friarbayliff/BBCLab/EAGLE/MSSRP-Sensor/BOM/MSSRP-Temperature_System_beta_lite_2layer.brd

## EAGLE design EAGLE/MSSRP-Sensor/BOM/MSSRP-Temperature_System_beta_lite_2layer.brd (2014-07-03)

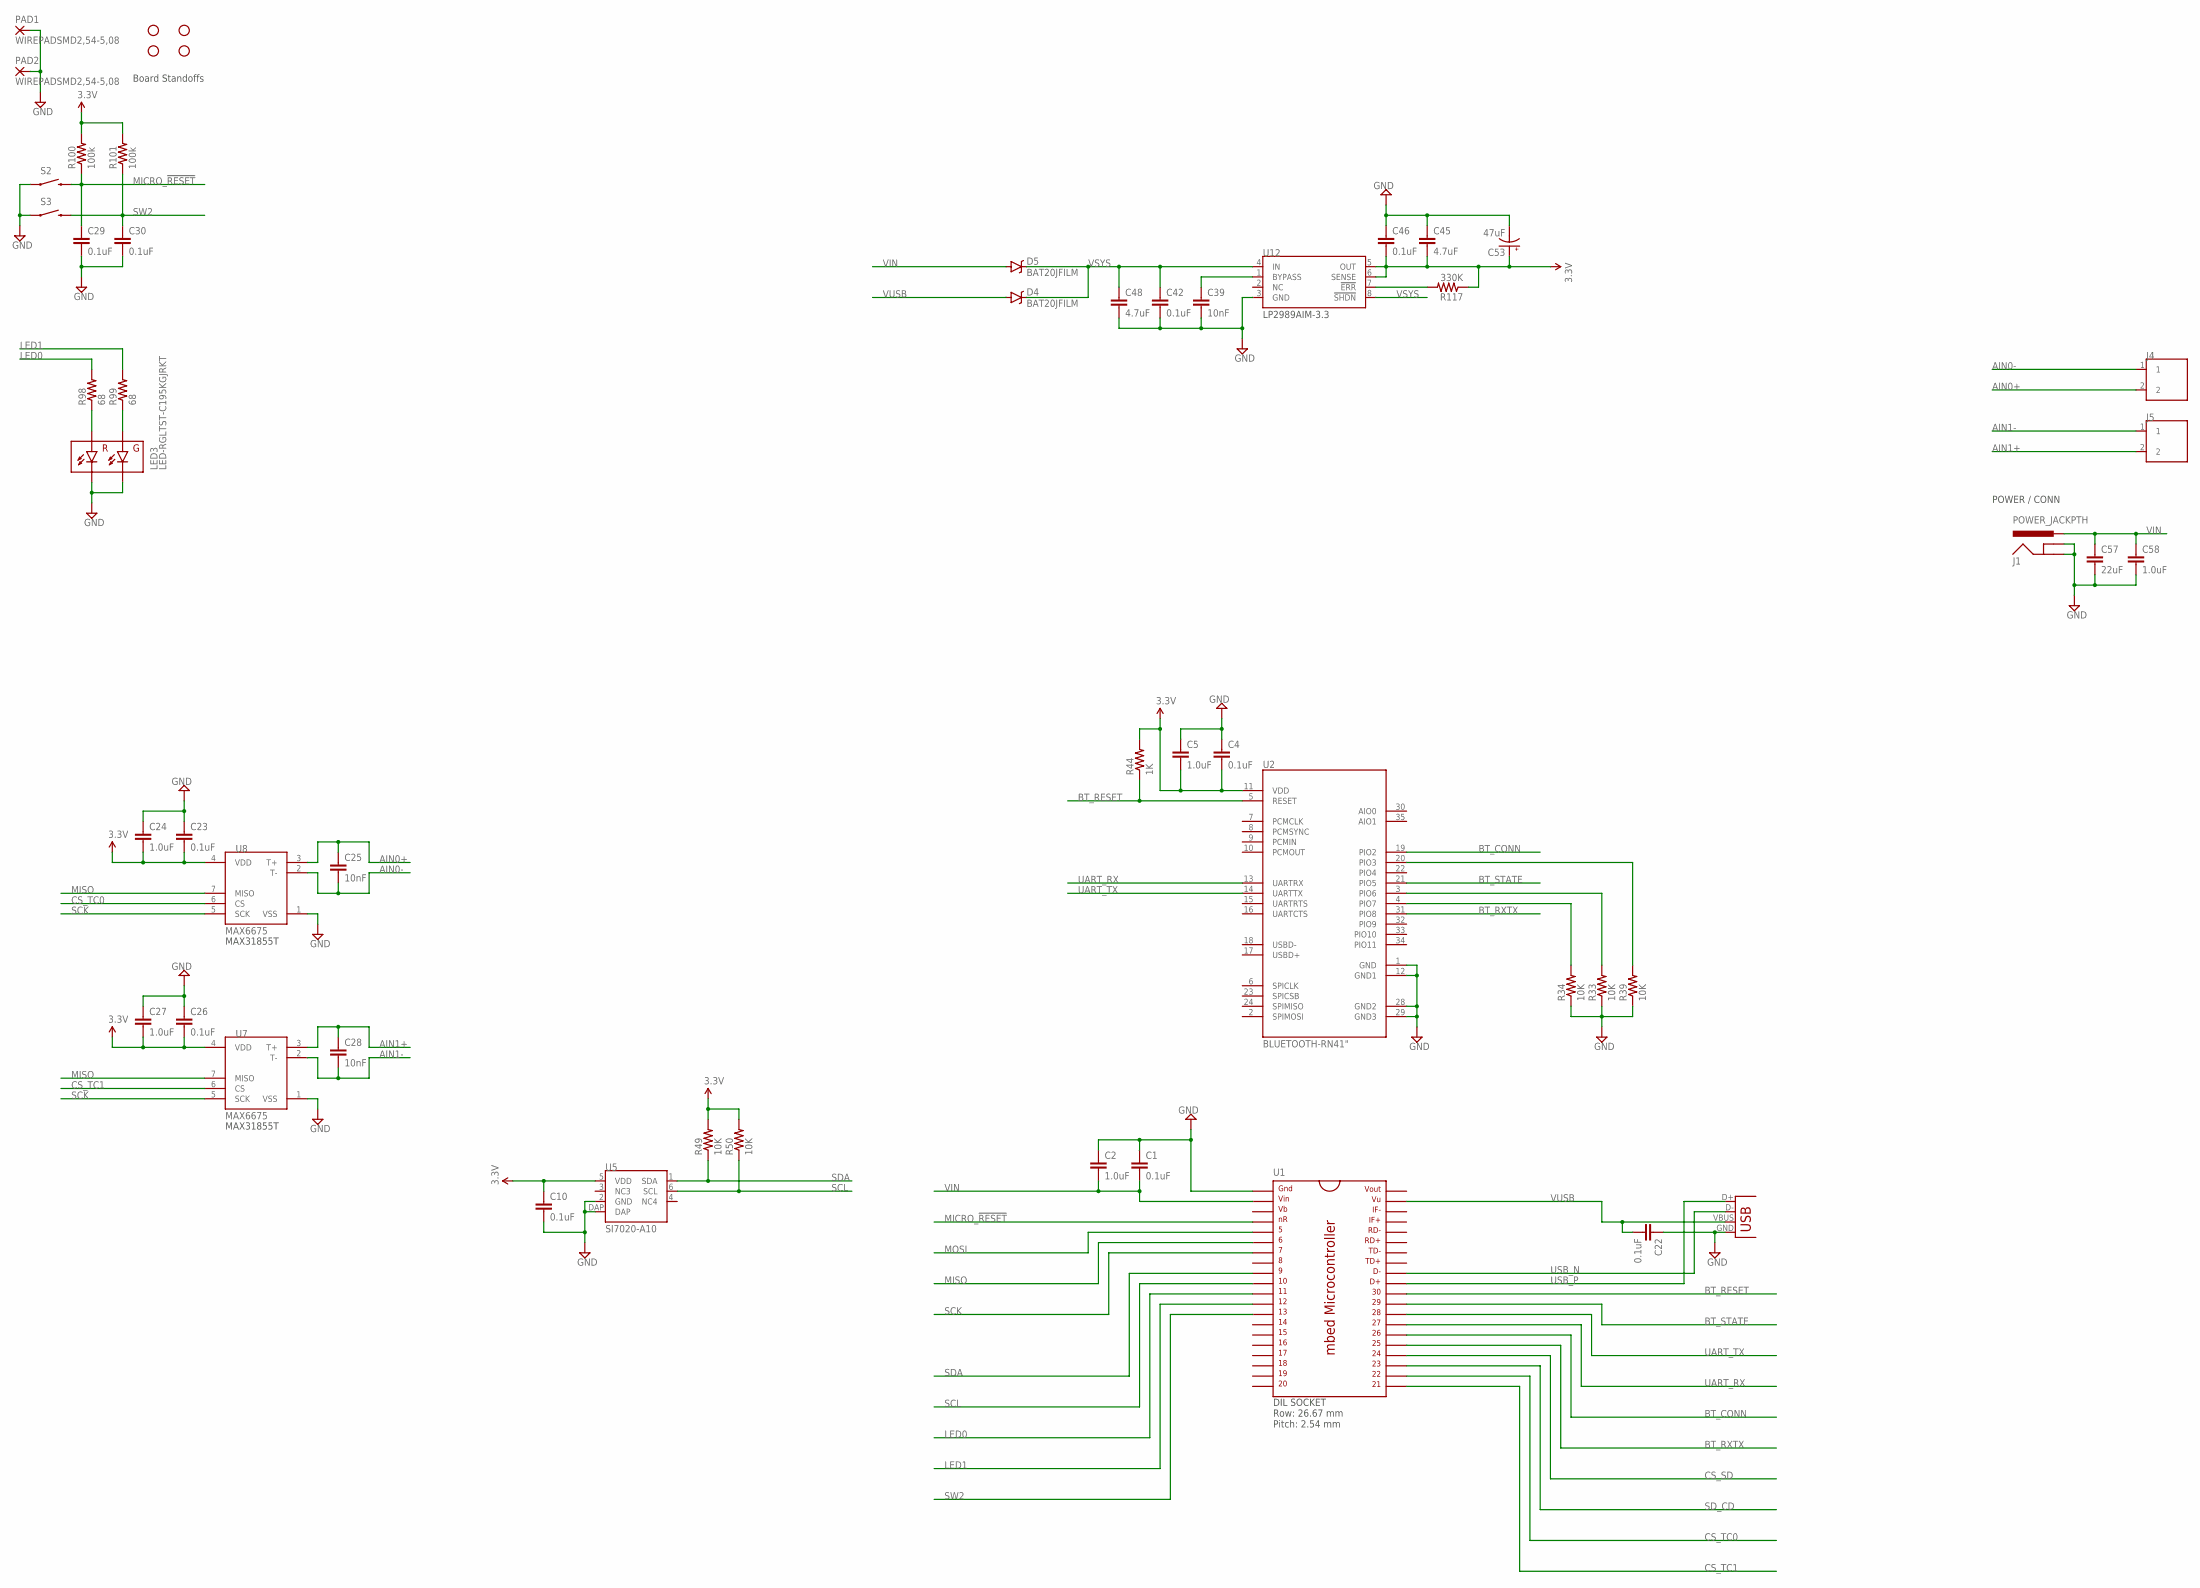
[picture p1: schematic MSSRP-Temperature_System_beta_lite_2layer.sch]

Parts:
C1, C4, C10, C22, C23, C26, C29, C30, C42, C46: 0.1uF; 0603-CAP
C2, C5, C24, C27, C58: 1.0uF; 0603-CAP
C25, C28, C39: 10nF; 0603-CAP
C45, C48: 4.7uF; 0603-CAP
C53: 47uF; EIA3528
C57: 22uF; 1210
D4, D5: BAT20JFILM; SOD-323
J1: POWER_JACKPTH; POWER_JACK_PTH
J4, J5: TE-2-TERMBLOCK
JP1: USB-A-SMD; USB-A-S-NOSILK-FEMALE
LED3: LED-RGLTST-C195KGJRKT; LTST-C195KGJRKT
PAD1, PAD2: WIREPADSMD2,54-5,08; SMD2,54-5,08
R33, R34, R39, R49, R50: 10K; 0603-RES
R44: 1K; 0603-RES
R98, R99: 68; 0603-RES
R100, R101: 100k; 0603-RES
R117: 330K; 0603-RES
S2, S3: SWITCH-MOMENTARY-2-SMD-1101NE; TACTILE-SWITCH-1101NE
STANDOFF1, STANDOFF2, STANDOFF3, STANDOFF4: STAND-OFF
U1: MBED; DIL40_0.9
U2: BLUETOOTH-RN41"; RN41
U5: SI7020-A10; DFN6
U7, U8: MAX6675; SO08-MAX6675
U12: LP2989AIM; SOIC8

Connections:
3.3V: C4.2, C5.2, C10.1, C23.2, C24.2, C26.2, C27.2, C45.2, C46.2, C53.A (+), R44.2, R49.2, R50.2, R100.2, R101.2, R117.1, U2.11 (VDD), U5.5 (VDD), U7.4 (VDD), U8.4 (VDD), U12.5 (OUT), U12.6 (SENSE)
AIN0+: C25.1, J4.2, U8.3 (T+)
AIN0-: C25.2, J4.1, U8.2 (T-)
AIN1+: C28.1, J5.2, U7.3 (T+)
AIN1-: C28.2, J5.1, U7.2 (T-)
BT_CONN: U1.26, U2.19 (PIO2)
BT_RESET: R44.1, U1.30, U2.5 (RESET)
BT_RXTX: U1.25, U2.31 (PIO8)
BT_STATE: U1.29, U2.21 (PIO5)
CS_SD: U1.24
CS_TC0: U1.22, U8.6 (CS)
CS_TC1: U1.21, U7.6 (CS)
GND: C1.1, C2.1, C4.1, C5.1, C10.2, C22.1, C23.1, C24.1, C26.1, C27.1, C29.2, C30.2, C39.2, C42.2, C45.1, C46.1, C48.2, C53.C (-), C57.2, C58.2, J1.GND, J1.GNDBREAK, JP1.GND, LED3.P$3 (GC), LED3.P$4 (RC), PAD1.1, PAD2.1, R33.1, R34.1, R39.1, S2.P$1 (1), S3.P$1 (1), U1.1, U2.1 (GND), U2.12 (GND1), U2.28 (GND2), U2.29 (GND3), U5.2 (GND), U5.DAP, U7.1 (VSS), U8.1 (VSS), U12.3 (GND)
LED0: R98.2, U1.11
LED1: R99.2, U1.12
MICRO_!RESET: C29.1, R100.1, S2.P$2 (2), U1.4
MISO: U1.6, U7.7 (MISO), U8.7 (MISO)
MOSI: U1.5
unnamed: R34.2, U2.4 (PIO7)
unnamed: R33.2, U2.3 (PIO6)
unnamed: R39.2, U2.20 (PIO3)
unnamed: LED3.P$2 (RA), R98.1
unnamed: LED3.P$1 (GA), R99.1
unnamed: C39.1, U12.1 (BYPASS)
unnamed: R117.2, U12.7 (!ERR)
SCK: U1.7, U7.5 (SCK), U8.5 (SCK)
SCL: R50.1, U1.10, U5.6 (SCL)
SDA: R49.1, U1.9, U5.1 (SDA)
SD_CD: U1.23
SW2: C30.1, R101.1, S3.P$2 (2), U1.13
UART_RX: U1.27, U2.13 (UARTRX)
UART_TX: U1.28, U2.14 (UARTTX)
USB_N: JP1.D-, U1.32
USB_P: JP1.D+, U1.31
VIN: C1.2, C2.2, C57.1, C58.1, D5.A, J1.PWR, U1.2
VSYS: C42.1, C48.1, D4.C, D5.C, U12.4 (IN), U12.8 (!SHDN)
VUSB: C22.2, D4.A, JP1.VBUS, U1.39

Notes on the sheet:
Board Standoffs
POWER / CONN
LP2989AIM-3.3
DIL SOCKET Row: 26.67 mm Pitch: 2.54 mm
MAX31855T

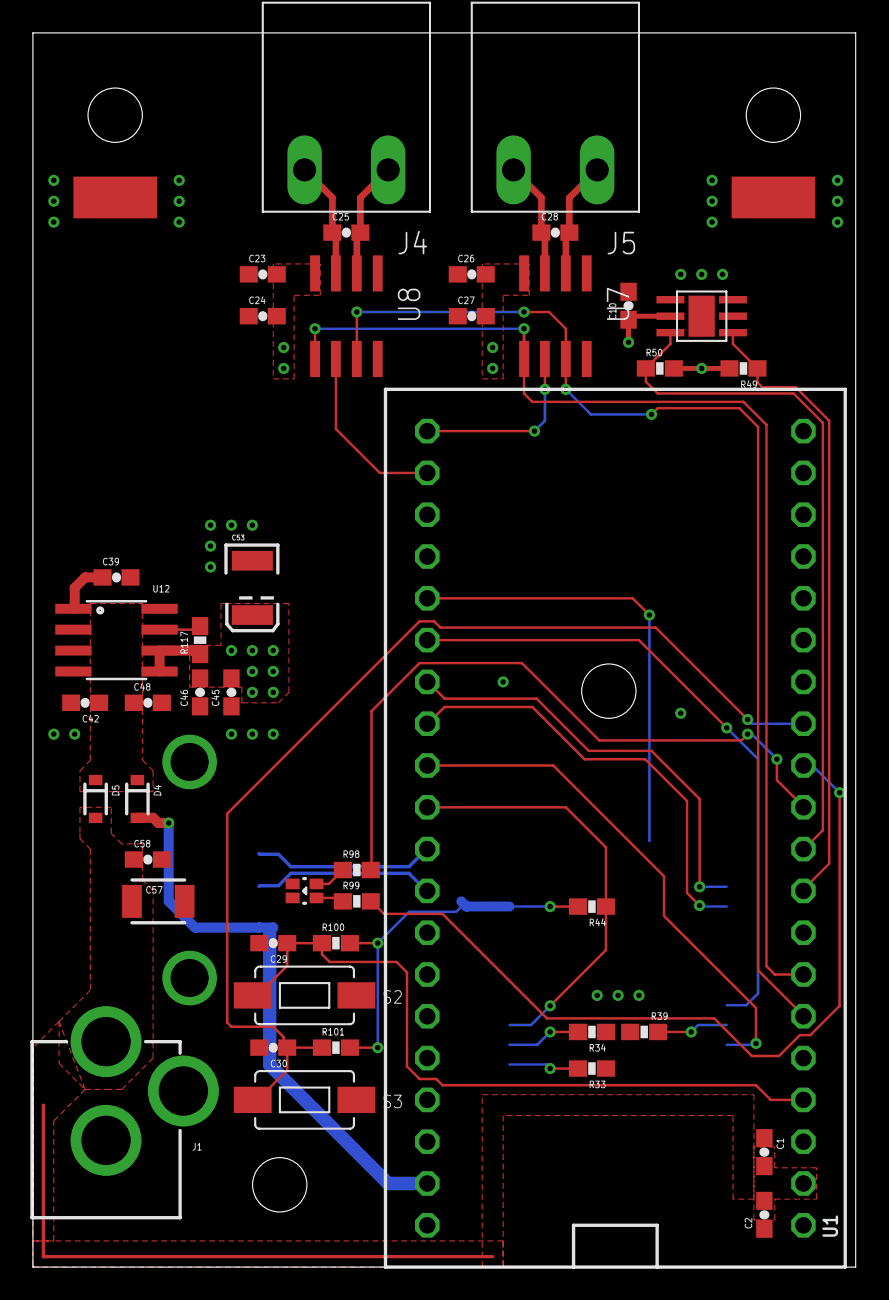
[picture p2: board MSSRP-Temperature_System_beta_lite_2layer.brd from above]

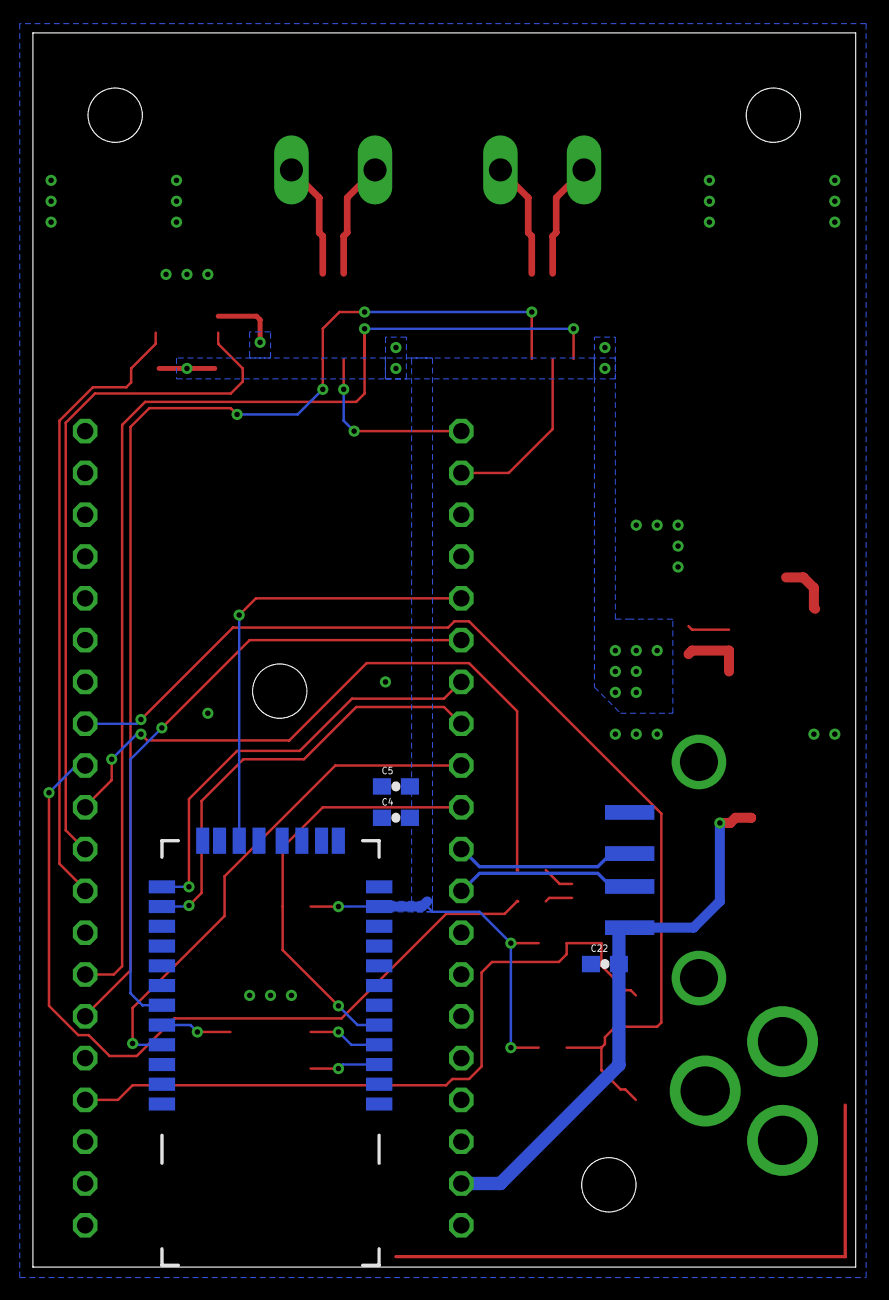
[picture p3: board MSSRP-Temperature_System_beta_lite_2layer.brd from below]

Board: 2 copper layers, 50.0 x 75.0 mm, 54 parts (5 on the bottom side), 34 nets.
