friarbayliff/BBCLab/EAGLE/MSSRP-Sensor/MSSRP-Temperature_System_beta_2layer.brd

## EAGLE design EAGLE/MSSRP-Sensor/MSSRP-Temperature_System_beta_2layer.brd (2014-06-30)

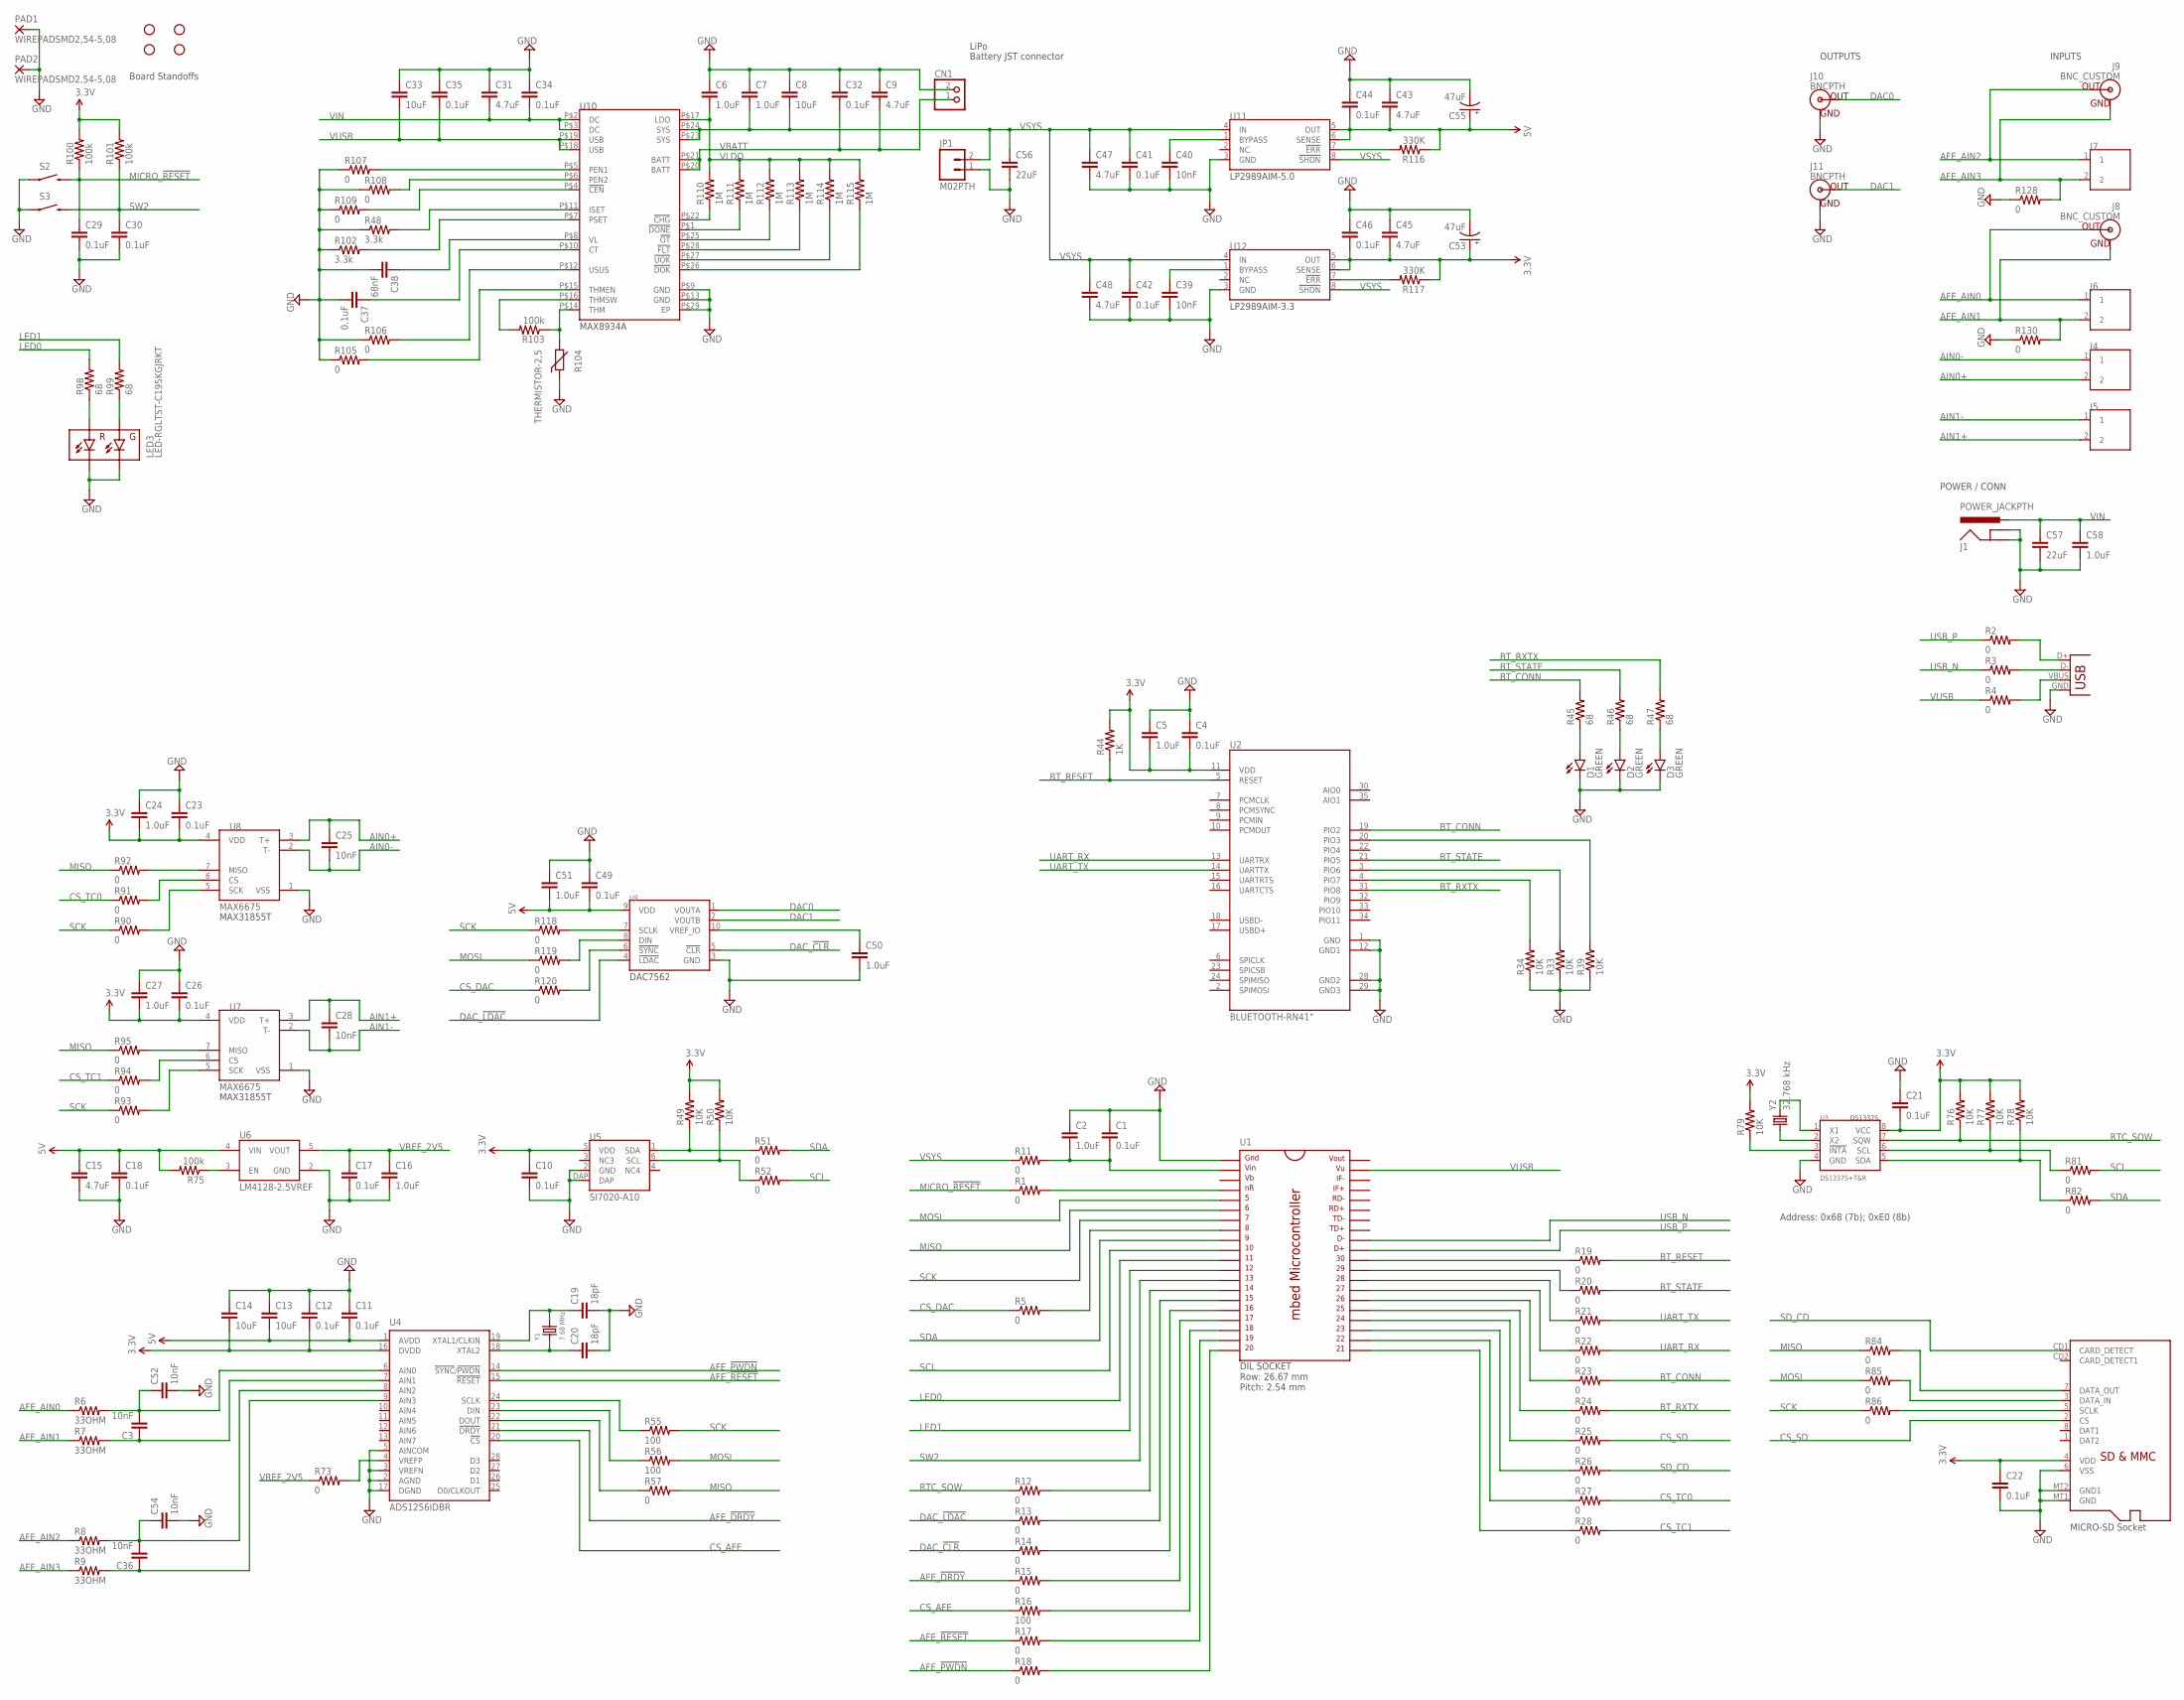
[picture p4: schematic MSSRP-Temperature_System_beta_2layer.sch]

Parts:
C1, C4, C10, C11, C12, C17, C18, C21, C22, C23, C26, C29, C30, C32, C34, C35, C37, C41, C42, C44, C46, C49: 0.1uF; 0603-CAP
C2, C5, C6, C7, C16, C24, C27, C50, C51, C58: 1.0uF; 0603-CAP
C3, C25, C28, C36, C39, C40, C52, C54: 10nF; 0603-CAP
C8, C13, C14, C33: 10uF; 0603-CAP
C9, C15, C31, C43, C45, C47, C48: 4.7uF; 0603-CAP
C19, C20: 18pF; 0603-CAP
C38: 68nF; 0603-CAP
C53, C55: 47uF; EIA3528
C56: 22uF; 0805
C57: 22uF; 1210
CN1: JST_2PIN-THM-RA; JST-PH-2-THM-RA
D1, D2, D3: GREEN; LED-0603
J1: POWER_JACKPTH; POWER_JACK_PTH
J2: USBSMD; USB-MINIB
J4, J5, J6, J7: TE-2-TERMBLOCK
J8, J9: BNC_CUSTOM
J10, J11: BNCPTH; BNC
JP1: M02PTH; 1X02
LED3: LED-RGLTST-C195KGJRKT; LTST-C195KGJRKT
PAD1, PAD2: WIREPADSMD2,54-5,08; SMD2,54-5,08
R1, R2, R3, R4, R5, R11, R12, R13, R14, R15, R17, R18, R19, R20, R21, R22, R23, R24, R25, R26, R27, R28, R51, R52, R57, R73, R81, R82, R84, R85, R86, R90, R91, R92, R93, R94, R95, R105, R106, R107, R108, R109, R118, R119, R120, R128, R130: 0; 0603
R6, R7, R8, R9: 33OHM; 0603
R16, R55, R56: 100; 0603-RES
R33, R34, R39, R49, R50, R76, R77, R78, R79: 10K; 0603-RES
R44: 1K; 0603-RES
R45, R46, R47, R98, R99: 68; 0603-RES
R48, R102: 3.3k; 0603-RES
R75, R100, R101, R103: 100k; 0603-RES
R104: THERMISTOR-2,5; RS-2,5
R110, R111, R112, R113, R114, R115: 1M; 0603-RES
R116, R117: 330K; 0603-RES
S2, S3: SWITCH-MOMENTARY-2-SMD-1101NE; TACTILE-SWITCH-1101NE
STANDOFF1, STANDOFF2, STANDOFF3, STANDOFF4: STAND-OFF
U1: MBED; DIL40_0.9
U2: BLUETOOTH-RN41"; RN41
U3: DS1337S+T&R; SOIC8
U4: ADS1256IDBR; SSOP28
U5: SI7020-A10; DFN6
U6: LM4128-2.5VREF; SOT23-5
U7, U8: MAX6675; SO08-MAX6675
U9: DAC7562; MSOP10
U10: MAX8934A; QFN28
U11, U12: LP2989AIM; SOIC8
U$1: MICROSD
Y1: 7.68 MHz; HC49UP
Y2: 32.768 kHz; HC49UP

Connections:
3.3V: C4.2, C5.2, C10.1, C12.2, C14.2, C21.2, C22.1, C23.2, C24.2, C26.2, C27.2, C45.2, C46.2, C53.A (+), R44.2, R49.2, R50.2, R76.2, R77.2, R78.2, R79.2, R100.2, R101.2, R117.1, U2.11 (VDD), U3.8 (VCC), U4.16 (DVDD), U5.5 (VDD), U7.4 (VDD), U8.4 (VDD), U12.5 (OUT), U12.6 (SENSE), U$1.4 (VDD)
5V: C11.2, C13.2, C15.1, C18.1, C43.2, C44.2, C49.2, C51.2, C55.A (+), R75.2, R116.1, U4.1 (AVDD), U6.4 (VIN), U9.9 (VDD), U11.5 (OUT), U11.6 (SENSE)
AFE_!DRDY: R15.1, U4.21 (!DRDY)
AFE_!PWDN: R18.1, U4.14 (!SYNC!/!PWDN)
AFE_!RESET: R17.1, U4.15 (!RESET)
AFE_AIN0: J6.1, J8.S (OUT), R6.1
AFE_AIN1: J6.2, J8.GND, R7.1, R130.2
AFE_AIN2: J7.1, J9.S (OUT), R8.1
AFE_AIN3: J7.2, J9.GND, R9.1, R128.2
AIN0+: C25.1, J4.2, U8.3 (T+)
AIN0-: C25.2, J4.1, U8.2 (T-)
AIN1+: C28.1, J5.2, U7.3 (T+)
AIN1-: C28.2, J5.1, U7.2 (T-)
BT_CONN: R23.2, R45.2, U2.19 (PIO2)
BT_RESET: R19.2, R44.1, U2.5 (RESET)
BT_RXTX: R24.2, R47.2, U2.31 (PIO8)
BT_STATE: R20.2, R46.2, U2.21 (PIO5)
CS_AFE: R16.1, U4.20 (!CS)
CS_DAC: R5.1, R120.1
CS_SD: R25.2, U$1.2 (CS)
CS_TC0: R27.2, R91.1
CS_TC1: R28.2, R94.1
DAC0: J10.S (OUT), U9.1 (VOUTA)
DAC1: J11.S (OUT), U9.2 (VOUTB)
DAC_!CLR: R14.1, U9.5 (!CLR)
DAC_!LDAC: R13.1, U9.4 (!LDAC)
GND: C1.1, C2.1, C4.1, C5.1, C6.1, C7.1, C8.1, C9.1, C10.2, C11.1, C12.1, C13.1, C14.1, C15.2, C16.2, C17.2, C18.2, C19.2, C20.2, C21.1, C22.2, C23.1, C24.1, C26.1, C27.1, C29.2, C30.2, C31.1, C32.1, C33.1, C34.1, C35.1, C37.2, C38.2, C39.2, C40.2, C41.2, C42.2, C43.1, C44.1, C45.1, C46.1, C47.2, C48.2, C49.1, C50.2, C51.1, C52.2, C53.C (-), C54.2, C55.C (-), C56.2, C57.2, C58.2, CN1.2 (1), D1.C, D2.C, D3.C, J1.GND, J1.GNDBREAK, J2.GND, J10.GND, J11.GND, JP1.1, LED3.P$3 (GC), LED3.P$4 (RC), PAD1.1, PAD2.1, R33.1, R34.1, R39.1, R48.1, R102.1, R104.1, R105.1, R106.1, R107.1, R108.1, R109.1, R128.1, R130.1, S2.P$1 (1), S3.P$1 (1), U1.1, U2.1 (GND), U2.12 (GND1), U2.28 (GND2), U2.29 (GND3), U3.4 (GND), U4.2 (AGND), U4.3 (VREFN), U4.5 (AINCOM), U4.17 (DGND), U5.2 (GND), U5.DAP, U6.2 (GND), U7.1 (VSS), U8.1 (VSS), U9.3 (GND), U10.P$9 (GND), U10.P$13 (GND), U10.P$29 (EP), U11.3 (GND), U12.3 (GND), U$1.6 (VSS), U$1.MT1 (GND), U$1.MT2 (GND1)
LED0: R98.2, U1.11
LED1: R99.2, U1.12
MICRO_!RESET: C29.1, R1.1, R100.1, S2.P$2 (2)
MISO: R57.2, R84.1, R92.1, R95.1, U1.6
MOSI: R56.2, R85.1, R119.1, U1.5
unnamed: R1.2, U1.4
unnamed: J2.D-, R3.2
unnamed: J2.D+, R2.2
unnamed: J2.VBUS, R4.2
unnamed: R5.2, U1.8
unnamed: C3.1, R7.2, U4.7 (AIN1)
unnamed: C1.2, C2.2, R11.2, U1.2
unnamed: C3.2, C52.1, R6.2, U4.6 (AIN0)
unnamed: C36.2, C54.1, R8.2, U4.8 (AIN2)
unnamed: C36.1, R9.2, U4.9 (AIN3)
unnamed: R12.2, U1.14
unnamed: R19.1, U1.30
unnamed: R13.2, U1.15
unnamed: R20.1, U1.29
unnamed: R21.1, U1.28
unnamed: R22.1, U1.27
unnamed: R23.1, U1.26
unnamed: R24.1, U1.25
unnamed: R14.2, U1.16
unnamed: R15.2, U1.17
unnamed: R16.2, U1.18
unnamed: R17.2, U1.19
unnamed: R18.2, U1.20
unnamed: R25.1, U1.24
unnamed: R26.1, U1.23
unnamed: R27.1, U1.22
unnamed: R28.1, U1.21
unnamed: R34.2, U2.4 (PIO7)
unnamed: R33.2, U2.3 (PIO6)
unnamed: R39.2, U2.20 (PIO3)
unnamed: D1.A, R45.1
unnamed: D2.A, R46.1
unnamed: D3.A, R47.1
unnamed: R49.1, R51.1, U5.1 (SDA)
unnamed: R50.1, R52.1, U5.6 (SCL)
unnamed: R55.1, U4.24 (SCLK)
unnamed: R56.1, U4.23 (DIN)
unnamed: R57.1, U4.22 (DOUT)
unnamed: R73.2, U4.4 (VREFP)
unnamed: R75.1, U6.3 (EN)
unnamed: C20.1, U4.18 (XTAL2), Y1.1
unnamed: C19.1, U4.19 (XTAL1/CLKIN), Y1.2
unnamed: U3.2 (X2), Y2.1
unnamed: U3.1 (X1), Y2.2
unnamed: R77.1, R81.1, U3.6 (SCL)
unnamed: R78.1, R82.1, U3.5 (SDA)
unnamed: R86.2, U$1.5 (SCLK)
unnamed: R85.2, U$1.3 (DATA_IN)
unnamed: R84.2, U$1.7 (DATA_OUT)
unnamed: R92.2, U8.7 (MISO)
unnamed: R91.2, U8.6 (CS)
unnamed: R90.2, U8.5 (SCK)
unnamed: R95.2, U7.7 (MISO)
unnamed: R94.2, U7.6 (CS)
unnamed: R93.2, U7.5 (SCK)
unnamed: LED3.P$2 (RA), R98.1
unnamed: LED3.P$1 (GA), R99.1
unnamed: R103.1, R104.2, U10.P$14 (THM)
unnamed: R103.2, U10.P$16 (THMSW)
unnamed: R105.2, U10.P$15 (THMEN)
unnamed: R106.2, U10.P$12 (USUS)
unnamed: R107.2, U10.P$5 (PEN1)
unnamed: R108.2, U10.P$6 (PEN2)
unnamed: R109.2, U10.P$4 (!CEN)
unnamed: R48.2, U10.P$11 (ISET)
unnamed: R102.2, U10.P$7 (PSET)
unnamed: C38.1, U10.P$8 (VL)
unnamed: C37.1, U10.P$10 (CT)
unnamed: R110.1, U10.P$22 (!CHG)
unnamed: R111.1, U10.P$1 (!DONE)
unnamed: R112.1, U10.P$25 (!OT)
unnamed: R113.1, U10.P$28 (!FLT)
unnamed: R114.1, U10.P$27 (!UOK)
unnamed: R115.1, U10.P$26 (!DOK)
unnamed: C40.1, U11.1 (BYPASS)
unnamed: C39.1, U12.1 (BYPASS)
unnamed: R116.2, U11.7 (!ERR)
unnamed: R117.2, U12.7 (!ERR)
unnamed: R118.2, U9.7 (SCLK)
unnamed: R119.2, U9.8 (DIN)
unnamed: R120.2, U9.6 (!SYNC)
unnamed: C50.1, U9.10 (VREF_IO)
RTC_!INTA: R79.1, U3.3 (!INTA)
RTC_SQW: R12.1, R76.1, U3.7 (SQW)
SCK: R55.2, R86.1, R90.1, R93.1, R118.1, U1.7
SCL: R52.2, R81.2, U1.10
SDA: R51.2, R82.2, U1.9
SD_CD: R26.2, U$1.CD1 (CARD_DETECT)
SW2: C30.1, R101.1, S3.P$2 (2), U1.13
UART_RX: R22.2, U2.13 (UARTRX)
UART_TX: R21.2, U2.14 (UARTTX)
USB_N: R3.1, U1.32
USB_P: R2.1, U1.31
VBATT: C9.2, C32.2, CN1.1 (2), U10.P$20 (BATT), U10.P$21 (BATT)
VIN: C31.2, C34.2, C57.1, C58.1, J1.PWR, U10.P$2 (DC), U10.P$3 (DC)
VLDO: C6.2, R110.2, R111.2, R112.2, R113.2, R114.2, R115.2, U10.P$17 (LDO)
VREF_2V5: C16.1, C17.1, R73.1, U6.5 (VOUT)
VSYS: C7.2, C8.2, C41.1, C42.1, C47.1, C48.1, C56.1, JP1.2, R11.1, U10.P$23 (SYS), U10.P$24 (SYS), U11.4 (IN), U11.8 (!SHDN), U12.4 (IN), U12.8 (!SHDN)
VUSB: C33.2, C35.2, R4.1, U1.39, U10.P$18 (USB), U10.P$19 (USB)

Notes on the sheet:
Board Standoffs
Address: 0x68 (7b); 0xE0 (8b)
LiPo
Battery JST connector
OUTPUTS
INPUTS
POWER / CONN
DAC7562
LP2989AIM-5.0
LP2989AIM-3.3
MAX8934A
DIL SOCKET Row: 26.67 mm Pitch: 2.54 mm
MICRO-SD Socket
MAX31855T
U10

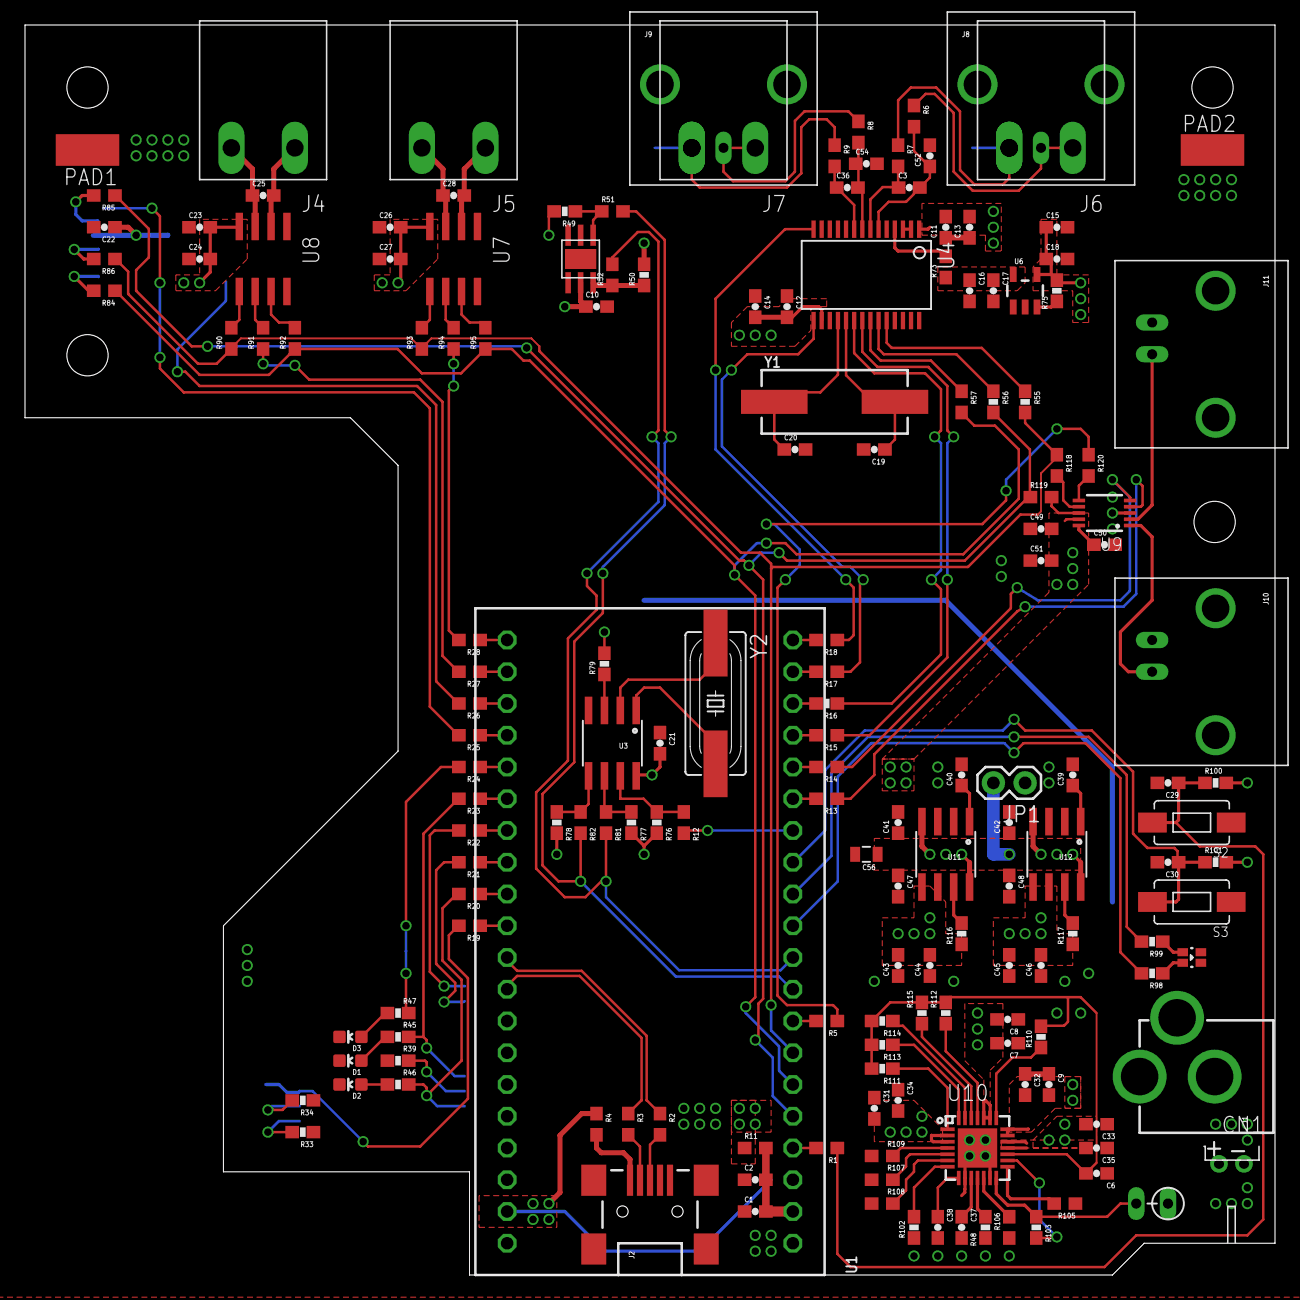
[picture p5: board MSSRP-Temperature_System_beta_2layer.brd from above]

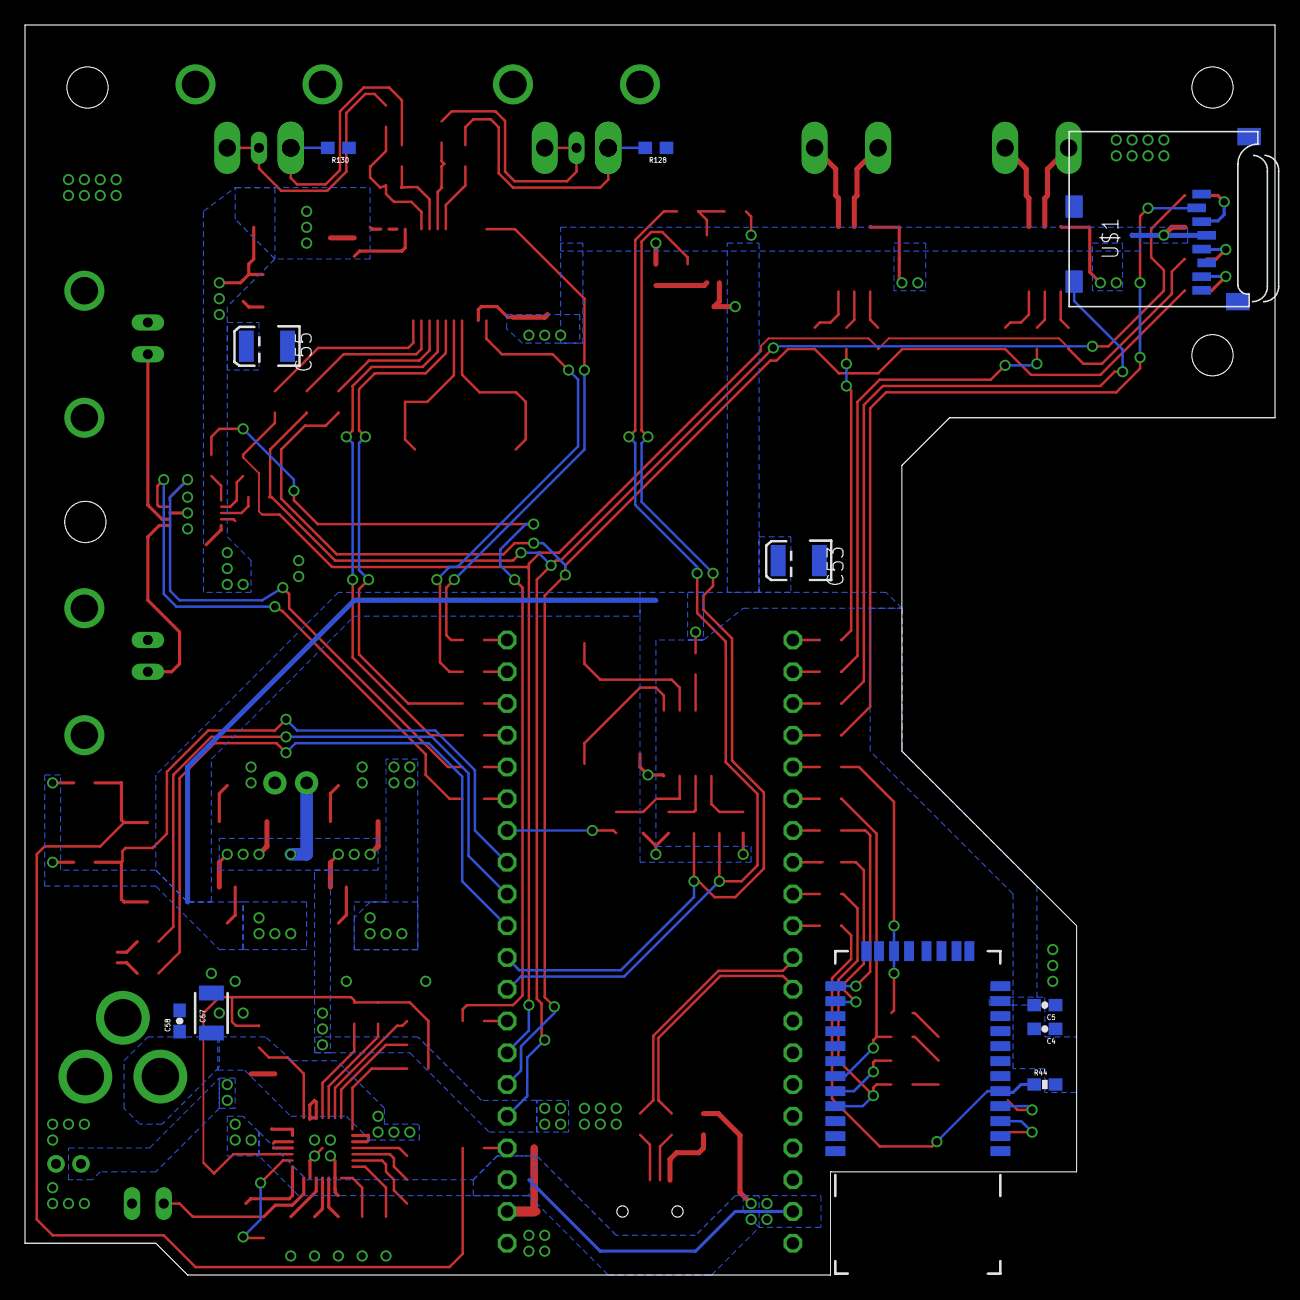
[picture p6: board MSSRP-Temperature_System_beta_2layer.brd from below]

Board: 2 copper layers, 100.0 x 100.0 mm, 181 parts (11 on the bottom side), 131 nets.
