friarbayliff/BBCLab/EAGLE/MSSRP-Sensor/MSSRP-PRESSURE_GEN_AFE.brd

## EAGLE design EAGLE/MSSRP-Sensor/MSSRP-PRESSURE_GEN_AFE.brd (2014-06-13)

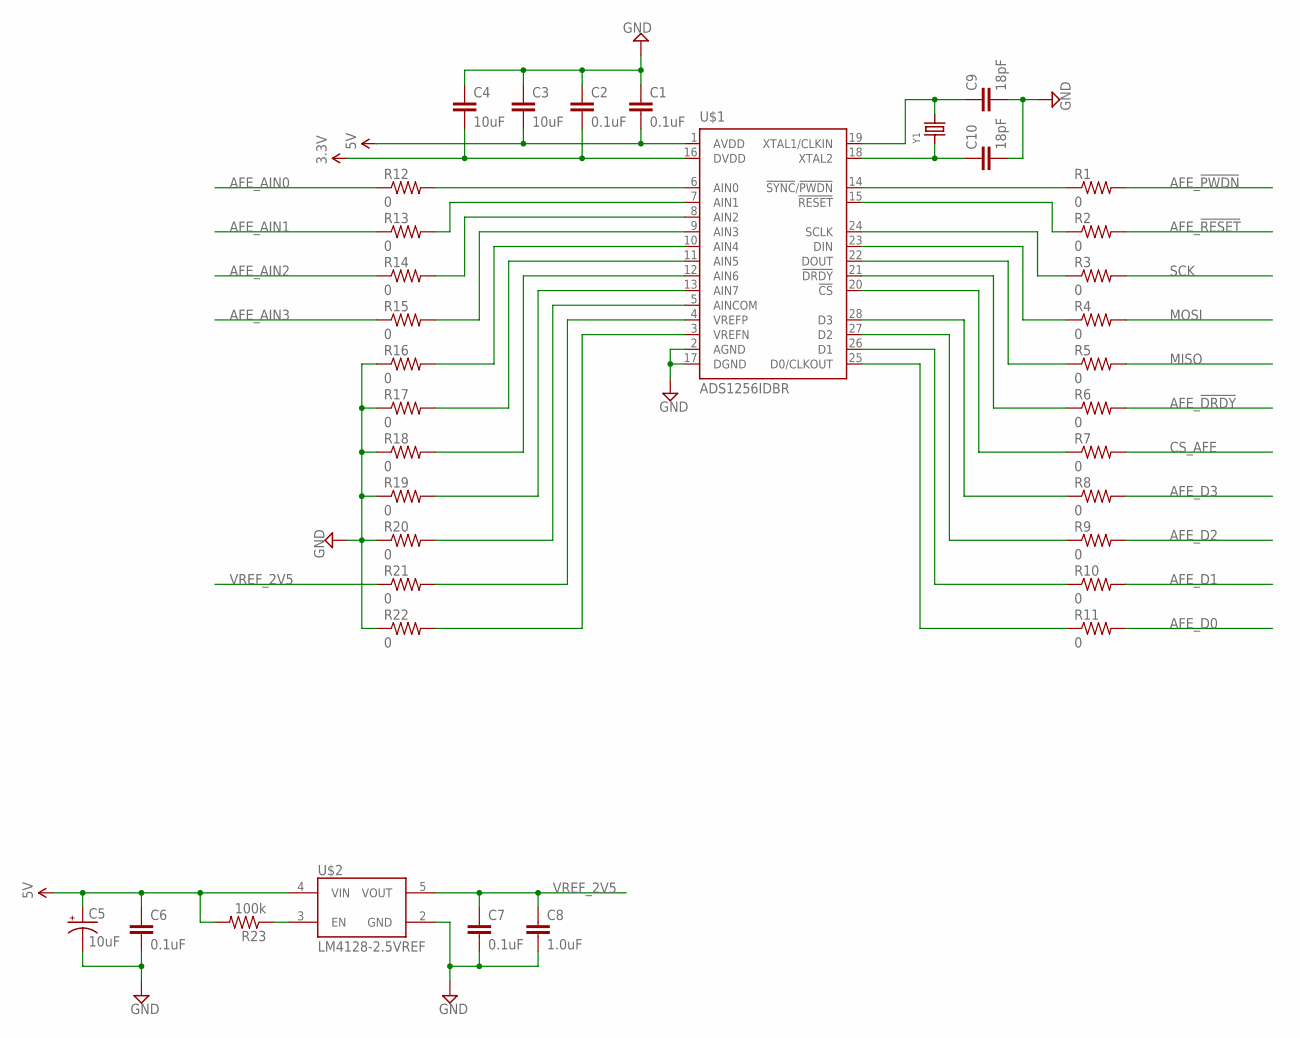
[picture p7: schematic MSSRP-PRESSURE_GEN_AFE.sch]

Parts:
C1, C2, C6, C7: 0.1uF; 0603-CAP
C3, C4: 10uF; 0603-CAP
C5: 10uF; EIA3216
C8: 1.0uF; 0603-CAP
C9, C10: 18pF; 0603-CAP
R1, R2, R3, R4, R5, R6, R7, R8, R9, R10, R11, R12, R13, R14, R15, R16, R17, R18, R19, R20, R21, R22: 0; 0603
R23: 100k; 0603-RES
U$1: ADS1256IDBR; SSOP28
U$2: LM4128-2.5VREF; SOT23-5
Y1: CRYSTALSMD; HC49UP

Connections:
3.3V: C2.2, C4.2, U$1.16 (DVDD)
5V: C1.2, C3.2, C5.A (+), C6.1, R23.2, U$1.1 (AVDD), U$2.4 (VIN)
AFE_!DRDY: R6.2
AFE_!PWDN: R1.2
AFE_!RESET: R2.2
AFE_AIN0: R12.1
AFE_AIN1: R13.1
AFE_AIN2: R14.1
AFE_AIN3: R15.1
AFE_D0: R11.2
AFE_D1: R10.2
AFE_D2: R9.2
AFE_D3: R8.2
CS_AFE: R7.2
GND: C1.1, C2.1, C3.1, C4.1, C5.C (-), C6.2, C7.2, C8.2, C9.2, C10.2, R16.1, R17.1, R18.1, R19.1, R20.1, R22.1, U$1.2 (AGND), U$1.17 (DGND), U$2.2 (GND)
MISO: R5.2
MOSI: R4.2
unnamed: R12.2, U$1.6 (AIN0)
unnamed: R13.2, U$1.7 (AIN1)
unnamed: R14.2, U$1.8 (AIN2)
unnamed: R15.2, U$1.9 (AIN3)
unnamed: R1.1, U$1.14 (!SYNC!/!PWDN)
unnamed: R2.1, U$1.15 (!RESET)
unnamed: R3.1, U$1.24 (SCLK)
unnamed: R4.1, U$1.23 (DIN)
unnamed: R5.1, U$1.22 (DOUT)
unnamed: R6.1, U$1.21 (!DRDY)
unnamed: R7.1, U$1.20 (!CS)
unnamed: R8.1, U$1.28 (D3)
unnamed: R9.1, U$1.27 (D2)
unnamed: R10.1, U$1.26 (D1)
unnamed: R11.1, U$1.25 (D0/CLKOUT)
unnamed: R16.2, U$1.10 (AIN4)
unnamed: R17.2, U$1.11 (AIN5)
unnamed: R18.2, U$1.12 (AIN6)
unnamed: R19.2, U$1.13 (AIN7)
unnamed: R20.2, U$1.5 (AINCOM)
unnamed: R21.2, U$1.4 (VREFP)
unnamed: R22.2, U$1.3 (VREFN)
unnamed: R23.1, U$2.3 (EN)
unnamed: C10.1, U$1.18 (XTAL2), Y1.1
unnamed: C9.1, U$1.19 (XTAL1/CLKIN), Y1.2
SCK: R3.2
VREF_2V5: C7.1, C8.1, R21.1, U$2.5 (VOUT)

Board: 2 copper layers, 36 parts (0 on the bottom side), 29 nets, no tracks yet.
