friarbayliff/BBCLab/EAGLE/MSSRP-Sensor/MSSRP-Connectors.brd

## EAGLE design EAGLE/MSSRP-Sensor/MSSRP-Connectors.brd (2014-06-13)

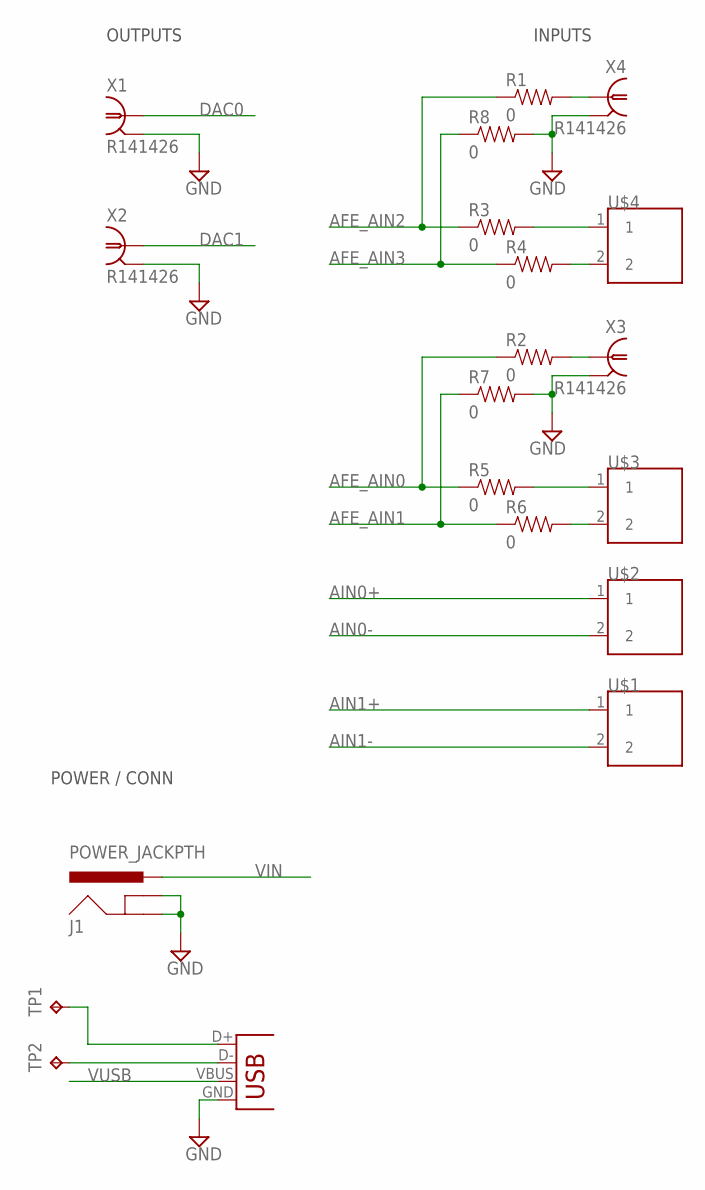
[picture p8: schematic MSSRP-Connectors.sch]

Parts:
J1: POWER_JACKPTH; POWER_JACK_PTH
JP1: USBSMD; USB-MINIB
R1, R2, R3, R4, R5, R6, R7, R8: 0; 0603
TP1, TP2: TPPAD1-13; P1-13
U$1, U$2, U$3, U$4: TE-2-TERMBLOCK
X1, X2, X3, X4: R141426

Connections:
AFE_AIN0: R2.1, R5.1
AFE_AIN1: R6.1, R7.1
AFE_AIN2: R1.1, R3.1
AFE_AIN3: R4.1, R8.1
AIN0+: U$2.1
AIN0-: U$2.2
AIN1+: U$1.1
AIN1-: U$1.2
DAC0: X1.1
DAC1: X2.1
GND: J1.GND, J1.GNDBREAK, JP1.GND, R7.2, R8.2, X1.2, X1.3 (2), X1.4 (2), X1.5 (2), X2.2, X2.3 (2), X2.4 (2), X2.5 (2), X3.2, X3.3 (2), X3.4 (2), X3.5 (2), X4.2, X4.3 (2), X4.4 (2), X4.5 (2)
unnamed: JP1.D-, TP2.TP
unnamed: R2.2, X3.1
unnamed: JP1.D+, TP1.TP
unnamed: R1.2, X4.1
unnamed: R3.2, U$4.1
unnamed: R4.2, U$4.2
unnamed: R5.2, U$3.1
unnamed: R6.2, U$3.2
VIN: J1.PWR
VUSB: JP1.VBUS

Notes on the sheet:
OUTPUTS
INPUTS
POWER / CONN

Board: 2 copper layers, 20 parts (0 on the bottom side), 13 nets, no tracks yet.
