friarbayliff/BBCLab/EAGLE/MSSRP-Sensor/MSSRP-Microcontroller.brd

## EAGLE design EAGLE/MSSRP-Sensor/MSSRP-Microcontroller.brd (2014-06-13)

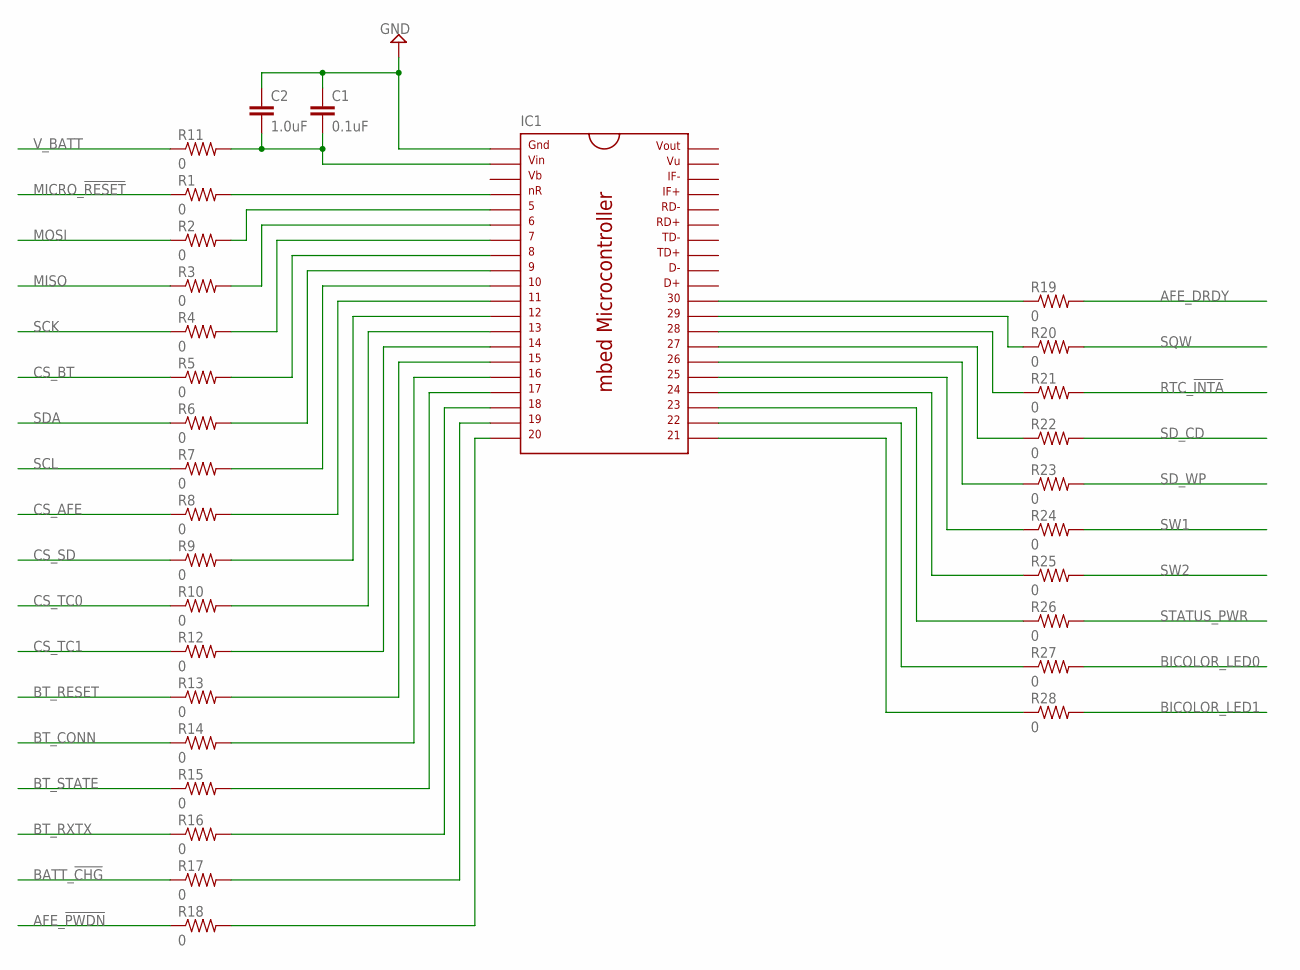
[picture p9: schematic MSSRP-Microcontroller.sch]

Parts:
C1: 0.1uF; 0603-CAP
C2: 1.0uF; 0603-CAP
IC1: MBED; DIL40_0.9
R1, R2, R3, R4, R5, R6, R7, R8, R9, R10, R11, R12, R13, R14, R15, R16, R17, R18, R19, R20, R21, R22, R23, R24, R25, R26, R27, R28: 0; 0603

Connections:
AFE_!PWDN: R18.1
AFE_DRDY: R19.2
BATT_!CHG: R17.1
BICOLOR_LED0: R27.2
BICOLOR_LED1: R28.2
BT_CONN: R14.1
BT_RESET: R13.1
BT_RXTX: R16.1
BT_STATE: R15.1
CS_AFE: R8.1
CS_BT: R5.1
CS_SD: R9.1
CS_TC0: R10.1
CS_TC1: R12.1
GND: C1.1, C2.1, IC1.1
MICRO_!RESET: R1.1
MISO: R3.1
MOSI: R2.1
unnamed: IC1.4, R1.2
unnamed: IC1.5, R2.2
unnamed: IC1.6, R3.2
unnamed: IC1.7, R4.2
unnamed: IC1.8, R5.2
unnamed: IC1.9, R6.2
unnamed: IC1.10, R7.2
unnamed: C1.2, C2.2, IC1.2, R11.2
unnamed: IC1.11, R8.2
unnamed: IC1.12, R9.2
unnamed: IC1.13, R10.2
unnamed: IC1.14, R12.2
unnamed: IC1.30, R19.1
unnamed: IC1.15, R13.2
unnamed: IC1.29, R20.1
unnamed: IC1.28, R21.1
unnamed: IC1.27, R22.1
unnamed: IC1.26, R23.1
unnamed: IC1.25, R24.1
unnamed: IC1.16, R14.2
unnamed: IC1.17, R15.2
unnamed: IC1.18, R16.2
unnamed: IC1.19, R17.2
unnamed: IC1.20, R18.2
unnamed: IC1.24, R25.1
unnamed: IC1.23, R26.1
unnamed: IC1.22, R27.1
unnamed: IC1.21, R28.1
RTC_!INTA: R21.2
SCK: R4.1
SCL: R7.1
SDA: R6.1
SD_CD: R22.2
SD_WP: R23.2
SQW: R20.2
STATUS_PWR: R26.2
SW1: R24.2
SW2: R25.2
V_BATT: R11.1

Board: 2 copper layers, 31 parts (0 on the bottom side), 29 nets, no tracks yet.
