friarbayliff/BBCLab/(commit log)

2014-06-04 second commit - adding schematic files
    [MSSRP-TC_IF.sch]
2014-06-04 added Bluetooth and RTC schematics
    [MSSRP-Bluetooth_IF.sch, MSSRP-RTC.sch]
2014-06-13 Update 3
    Added Main Board Files
    [MSSRP-BATT.sch, MSSRP-Connectors.brd, MSSRP-Connectors.sch, MSSRP-DAC.sch, MSSRP-HUMID_TEMP_SENSE.sch, MSSRP-Mechanical.sch, MSSRP-Microcontroller.brd, MSSRP-Microcontroller.sch]
2014-06-13 Ignore list
    Updated Git ignore list and AFE subsystem files
    [MSSRP-PRESSURE_GEN_AFE.brd, MSSRP-PRESSURE_GEN_AFE.sch]
2014-06-13 Layout start
    Some schematic changes, eliminating several 0-ohm “oops” resistors.
    General layout OK, initial routing started.
    [MSSRP-Temperature_System_beta.brd, MSSRP-Temperature_System_beta.sch]
2014-06-13 Updated routing
    Schematic and routing edits. Core power routing done.
    [MSSRP-Temperature_System_beta.brd, MSSRP-Temperature_System_beta.sch]
2014-06-16 Routing Update - 2-layer
    Finished 4-layer route. Added 2-layer routing attempt for cost savings.
    [MSSRP-Temperature_System_beta_2layer.brd, MSSRP-Temperature_System_beta_2layer.sch]
2014-06-17 2-layer routing
    Finished 2-layer routing tasks
    [MSSRP-Temperature_System_beta_2layer.brd, MSSRP-Temperature_System_beta_2layer.sch]
2014-06-17 Final Beta
    Finished schematic checks and routing adjustments. Boards ready for
    initial CAM.
    [MSSRP-Temperature_System_beta_2layer.brd, MSSRP-Temperature_System_beta_2layer.sch]
2014-06-18 DRC and Power pin
    Adjustments to pass DRC: miscellaneous clearance issues and
    double-drill issue with dual connector footprint.
    Also added pin header connection (JP1) to VSYS as a battery system
    bypass option for testing.
    [MSSRP-Temperature_System_beta_2layer.brd, MSSRP-Temperature_System_beta_2layer.sch]
2014-06-18 Layer 49
    Added 6 mil outline on layer 49 to export as board outline for 3D
    modeling.
    [MSSRP-Temperature_System_beta_2layer.brd]
2014-06-18 Final adjustments
    Silkscreen cleanup and minor adjustments before final submission to the
    board house.
    [MSSRP-Temperature_System_beta_2layer.brd, MSSRP-Temperature_System_beta_2layer.sch]
2014-06-19 Minor tweaks
    Minor visual tweaks to the schematic file
    [MSSRP-Temperature_System_beta_2layer.sch]
2014-06-30 Minor changes
    [MSSRP-Temperature_System_beta_2layer.brd, MSSRP-Temperature_System_beta_2layer.sch]
2014-07-03 Lite Version
    Added stripped-down ‘lite’ version of the board targeting temperature
    and humidity sensing only
    [MSSRP-Temperature_System_beta_lite_2layer.brd, MSSRP-Temperature_System_beta_lite_2layer.sch]
2014-07-03 Final Routing
    Final routing complete
    [MSSRP-Temperature_System_beta_lite_2layer.brd, MSSRP-Temperature_System_beta_lite_2layer.sch]
